bryanbendall/Brytec_SwitchPanelRev1/Board/Switch Panel Rev 1/Switch Panel Rev 1.kicad_pcb

## KiCad design Board/Switch Panel Rev 1/Switch Panel Rev 1.kicad_pcb (2023-09-28)

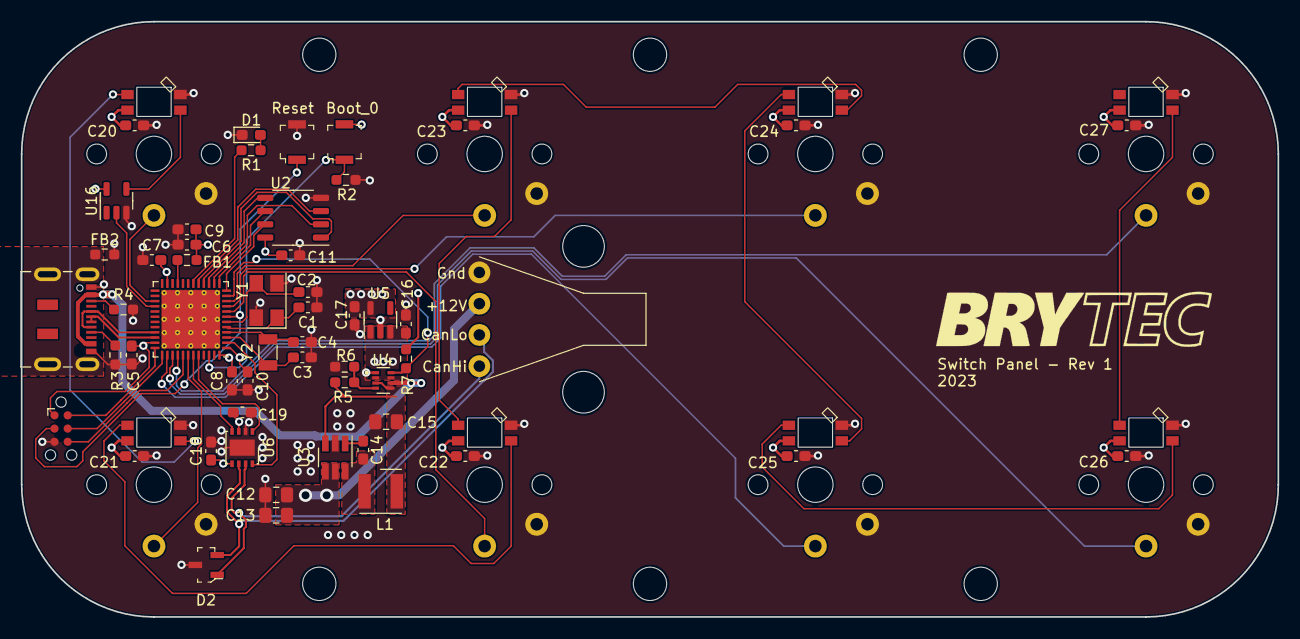
[picture p1: board Switch Panel Rev 1.kicad_pcb from above]

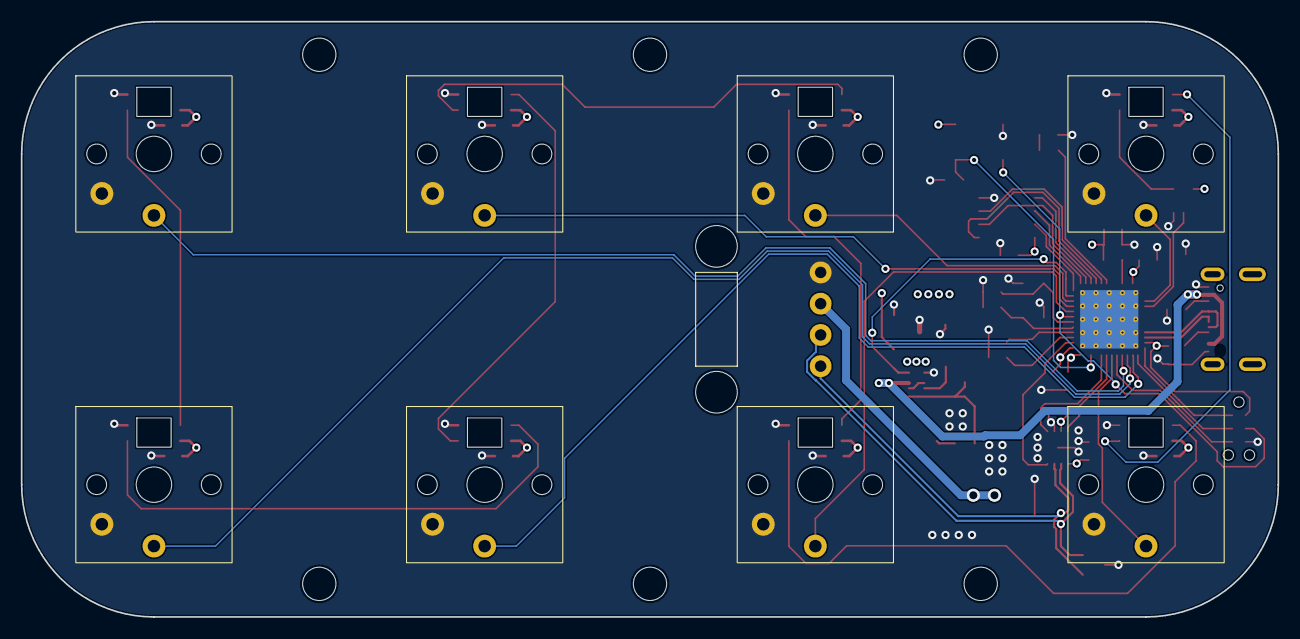
[picture p2: board Switch Panel Rev 1.kicad_pcb from below]

Board: 4 copper layers, 120.7 x 57.1 mm, 61 parts (8 on the bottom side), 55 nets.

Parts:
C1, C2, C3, C4: 10pF; C_0603_1608Metric_Pad1.08x0.95mm_HandSolder
C5, C7, C8, C10, C11, C14, C18, C19, C20, C21, C22, C23, C24, C25, C26, C27: 0.1uF; C_0603_1608Metric_Pad1.08x0.95mm_HandSolder
C6, C16, C17: 1uF; C_0603_1608Metric_Pad1.08x0.95mm_HandSolder
C9: 10nF; C_0603_1608Metric_Pad1.08x0.95mm_HandSolder
C12: 4.7uF; C_0805_2012Metric_Pad1.18x1.45mm_HandSolder
C13: 0.1uF; C_0805_2012Metric_Pad1.18x1.45mm_HandSolder
C15: 10uF; C_0805_2012Metric_Pad1.18x1.45mm_HandSolder
D1: LED_Small; LED_0603_1608Metric_Pad1.05x0.95mm_HandSolder
D2: PESD2CAN_215; SOT-23-3
FB1, FB2: FerriteBead_Small; R_0603_1608Metric_Pad0.98x0.95mm_HandSolder
J1: Conn_ARM_SWD_TagConnect_TC2030-NL; Tag-Connect_TC2030-IDC-NL_2x03_P1.27mm_Vertical
J2: USB_C_Receptacle_USB2.0; USB_C_Receptacle_JAE_DX07S016JA1R1500
J3: Conn_01x04; Tie Wrap Connector
L1: 6.8uH; L_Wurth_WE-LQSH-4020
R1: 65; R_0603_1608Metric_Pad0.98x0.95mm_HandSolder
R2, R5, R6, R7: 10K; R_0603_1608Metric_Pad0.98x0.95mm_HandSolder
R3, R4: 5.1K; R_0603_1608Metric_Pad0.98x0.95mm_HandSolder
S1, S2: B3U-1000P; Switch_Tactile_SMD_B3U-1000P
U1: STM32G491CEUx; QFN-48-1EP_7x7mm_P0.5mm_EP5.6x5.6mm_ThermalVias
U2: MB85RS64; SSOP-8_3.9x5.05mm_P1.27mm
U3: LMR50410Y5FQDBVRQ1; SOT-23-6_Handsoldering
U4: TPS2116DRLR; SOTFL50P160X60-8N
U5: AP2112K-3.3; SOT-23-5
U6: MCP2558FD-xMF; DFN-8-1EP_3x3mm_P0.65mm_EP1.55x2.4mm
U7, U8, U9, U10, U11, U12, U13, U14: SW_Kailh_Choc_RGB
U16: SN74LV1T34DBV; SOT-23-5
Y1: 8MHz; Crystal_SMD_5032-4Pin_5.0x3.2mm
Y2: 32.768kHz; Crystal_SMD_3215-2Pin_3.2x1.5mm

Connections:
+3.3V: C5.2, C6.2, C7.2, C8.2, C9.2, C10.2, C11.1, C17.1, C18.1, FB1.1, J1.1 (VCC), R7.1, S2.2, U1.1 (VBAT), U1.23 (VDD), U1.35 (VDD), U1.48 (VDD), U2.8 (VDD), U5.5 (VOUT), U6.5 (VIO)
+5V: C16.1, C19.1, C20.1, C21.1, C22.1, C23.1, C24.1, C25.1, C26.1, C27.1, U4.2 (VOUT), U4.7 (VOUT), U5.1 (VIN), U5.3 (EN), U6.3 (VDD), U7.1 (VDD), U8.1 (VDD), U9.1 (VDD), U10.1 (VDD), U11.1 (VDD), U12.1 (VDD), U13.1 (VDD), U14.1 (VDD), U16.5 (VCC)
/Mcu/BOOT_0: R2.1, S2.1, U1.46 (PB8)
/Mcu/Memory_Hold: U1.12 (PA4), U2.7 (~HOLD)
/Mcu/Memory_Wp: U1.17 (PB0), U2.3 (~WP)
/Mcu/RESET: J1.3 (~RESET), S1.1, U1.7 (PG10)
/Mcu/SPI1_SS_Memory: U1.16 (PC4), U2.1 (~CS)
/Mcu/SWCLK: J1.4 (SWCLK), U1.37 (PA14)
/Mcu/SWDIO: J1.2 (SWDIO), U1.36 (PA13)
/Mcu/SWO: J1.6 (SWO), U1.41 (PB3)
/Mcu/Usb D+: J2.A6 (D+), J2.B6 (D+), U1.34 (PA12)
/Mcu/Usb D-: J2.A7 (D-), J2.B7 (D-), U1.33 (PA11)
/Mcu/Usb_Shield: FB2.1, J2.S1 (SHIELD)
/Mcu/User_Led: R1.1, U1.18 (PB1)
Can+: D2.1 (C1), J3.1, U6.7 (CANH)
Can-: D2.2 (C2), J3.2, U6.6 (CANL)
CanRx: U1.43 (PB5), U6.4 (RXD)
CanSilent: U1.2 (PC13), U6.8 (S)
CanTx: U1.44 (PB6), U6.1 (TXD)
GND: C1.1, C2.1, C3.1, C4.1, C5.1, C6.1, C7.1, C8.1, C9.1, C10.1, C11.2, C12.2, C13.2, C15.2, C16.2, C17.2, C18.2, C19.2, C20.2, C21.2, C22.2, C23.2, C24.2, C25.2, C26.2, C27.2, D1.1 (K), D2.3 (C3), FB2.2, J1.5 (GND), J2.A1 (GND), J2.A12 (GND), J2.B1 (GND), J2.B12 (GND), J3.4, R2.2, R3.2, R4.2, R6.2, S1.2, U1.49 (VSS), U2.4 (GND), U3.2 (GND), U4.1 (GND), U5.2 (GND), U6.2 (VSS), U6.9 (VSS), U7.3 (GND), U7.6, U8.3 (GND), U8.6, U9.3 (GND), U9.6, U10.3 (GND), U10.6, U11.3 (GND), U11.6, U12.3 (GND), U12.6, U13.3 (GND), U13.6, U14.3 (GND), U14.6, U16.3 (GND), Y1.2, Y1.4
Ignition: C12.1, C13.1, J3.3, U3.4 (EN), U3.5 (VIN)
unnamed: D1.2 (A), R1.2
unnamed: J2.A5 (CC1), R4.1
unnamed: J2.B5 (CC2), R3.1
unnamed: C3.2, U1.3 (PC14), Y2.2
unnamed: C4.2, U1.4 (PC15), Y2.1
unnamed: C1.2, U1.5 (PF0), Y1.1
unnamed: C2.2, U1.6 (PF1), Y1.3
unnamed: FB1.2, U1.21 (VDDA)
unnamed: C14.2, U3.1 (CB)
unnamed: C14.1, L1.1, U3.6 (SW)
unnamed: R5.2, R6.1, U4.4 (PR1)
unnamed: U7.2 (DO), U9.4 (DI)
unnamed: U8.2 (DO), U10.4 (DI)
unnamed: U10.2 (DO), U12.4 (DI)
unnamed: U9.2 (DO), U11.4 (DI)
unnamed: U11.2 (DO), U13.4 (DI)
unnamed: U12.2 (DO), U14.4 (DI)
unnamed: U8.4 (DI), U13.2 (DO)
unnamed: U7.4 (DI), U16.4 (Y)
PowerSwitchStatus: R7.2, U1.11 (PA3), U4.8 (ST)
RGB_DI: U1.28 (PB15), U16.2 (A)
Regulated 5V: C15.1, L1.2, R5.1, U3.3 (FB), U4.3 (VIN1), U4.5 (MODE)
SPI1_Miso: U1.14 (PA6), U2.2 (SO)
SPI1_Mosi: U1.15 (PA7), U2.5 (SI)
SPI1_Sclk: U1.13 (PA5), U2.6 (SCK)
Sw1: U1.27 (PB14), U7.5
Sw2: U1.42 (PB4), U9.5
Sw3: U1.8 (PA0), U11.5
Sw4: U1.10 (PA2), U13.5
Sw5: U1.9 (PA1), U8.5
Sw6: U1.38 (PA15), U10.5
Sw7: U1.39 (PC10), U12.5
Sw8: U1.40 (PC11), U14.5
Usb 5V: J2.A4 (VBUS), J2.A9 (VBUS), J2.B4 (VBUS), J2.B9 (VBUS), U4.6 (VIN2)
