bryanbendall/Brytec_SwitchPanelRev1/Firmware/SwitchPanelRev1.ioc

Mcu.UserName=STM32G491CEUx
PA0.GPIO_Label=Sw3
PA0.Signal=GPIO_Input
PA1.GPIO_Label=Sw5
PA1.Signal=GPIO_Input
PA11.Signal=USB_DM
PA12.Signal=USB_DP
PA13.Signal=SYS_JTMS-SWDIO
PA14.Signal=SYS_JTCK-SWCLK
PA15.GPIO_Label=Sw6
PA15.Signal=GPIO_Input
PA2.GPIO_Label=Sw4
PA2.Signal=GPIO_Input
PA3.GPIO_Label=PowerSwitchStatus
PA3.Signal=GPIO_Input
PA4.GPIO_Label=Memory_Hold
PA4.Signal=GPIO_Output
PA5.Signal=SPI1_SCK
PA6.Signal=SPI1_MISO
PA7.Signal=SPI1_MOSI
PB0.GPIO_Label=Memory_Wp
PB0.Signal=GPIO_Output
PB1.GPIO_Label=User_Led
PB1.Signal=GPIO_Output
PB14.GPIO_Label=Sw1
PB14.Signal=GPIO_Input
PB15.Signal=TIM1_CH3N
PB4.GPIO_Label=Sw2
PB4.Signal=GPIO_Input
PB5.Signal=FDCAN2_RX
PB6.Signal=FDCAN2_TX
PC10.GPIO_Label=Sw7
PC10.Signal=GPIO_Input
PC11.GPIO_Label=Sw8
PC11.Signal=GPIO_Input
PC13.GPIO_Label=CanSilent
PC13.Signal=GPIO_Output
PC14-OSC32_IN.Signal=RCC_OSC32_IN
PC15-OSC32_OUT.Signal=RCC_OSC32_OUT
PC4.GPIO_Label=Memory_SS
PC4.Signal=GPIO_Output
PF0-OSC_IN.Signal=RCC_OSC_IN
PF1-OSC_OUT.Signal=RCC_OSC_OUT
