bryanbendall/Brytec_SwitchPanelRev1/Firmware/Core/Inc/main.h

#define CanSilent_Pin GPIO_PIN_13
#define CanSilent_GPIO_Port GPIOC
#define Sw3_Pin GPIO_PIN_0
#define Sw3_GPIO_Port GPIOA
#define Sw5_Pin GPIO_PIN_1
#define Sw5_GPIO_Port GPIOA
#define Sw4_Pin GPIO_PIN_2
#define Sw4_GPIO_Port GPIOA
#define PowerSwitchStatus_Pin GPIO_PIN_3
#define PowerSwitchStatus_GPIO_Port GPIOA
#define Memory_Hold_Pin GPIO_PIN_4
#define Memory_Hold_GPIO_Port GPIOA
#define Memory_SS_Pin GPIO_PIN_4
#define Memory_SS_GPIO_Port GPIOC
#define Memory_Wp_Pin GPIO_PIN_0
#define Memory_Wp_GPIO_Port GPIOB
#define User_Led_Pin GPIO_PIN_1
#define User_Led_GPIO_Port GPIOB
#define Sw1_Pin GPIO_PIN_14
#define Sw1_GPIO_Port GPIOB
#define Sw6_Pin GPIO_PIN_15
#define Sw6_GPIO_Port GPIOA
#define Sw7_Pin GPIO_PIN_10
#define Sw7_GPIO_Port GPIOC
#define Sw8_Pin GPIO_PIN_11
#define Sw8_GPIO_Port GPIOC
#define Sw2_Pin GPIO_PIN_4
#define Sw2_GPIO_Port GPIOB
