bryanbendall/Brytec_SwitchPanelRev1/Firmware/App/SwitchPanelRev1Defs.h

#pragma once

#include <stdint.h>

// Pin Defines
#define BT_PIN_Button_1 0
#define BT_PIN_Button_2 1
#define BT_PIN_Button_3 2
#define BT_PIN_Button_4 3
#define BT_PIN_Button_5 4
#define BT_PIN_Button_6 5
#define BT_PIN_Button_7 6
#define BT_PIN_Button_8 7
#define BT_PIN_Light_1 8
#define BT_PIN_Light_2 9
#define BT_PIN_Light_3 10
#define BT_PIN_Light_4 11
#define BT_PIN_Light_5 12
#define BT_PIN_Light_6 13
#define BT_PIN_Light_7 14
#define BT_PIN_Light_8 15

// Can Bus Defines
#define BT_CAN_Yellow_Green 0

// Module Template
constexpr uint8_t moduleTemplate[] = {
0x54,0x4d,0,0x1,0x12,0,0,0,0x53,0x77,0x69,0x74,0x63,0x68,0x20,0x50,0x61,0x6e,0x65,0x6c,0x20,0x52,0x65,0x76,0x20,0x31,0x6,0,0,0,0x42,0x72,0x79,0x74,0x65,0x63,0x12,0,0,0,0x53,0x77,0x69,0x74,0x63,0x68,0x20,0x50,0x61,0x6e,0x65,0x6c,0x20,0x52,0x65,0x76,0x20,0x31,0x28,0x1,0x6,0,0,0,0x59,0x65,0x6c,0x6c,0x6f,0x77,0x5,0,0,0,0x47,0x72,0x65,0x65,0x6e,0x10,0,0x8,0,0,0,0x42,0x75,0x74,0x74,0x6f,0x6e,0x20,0x31,0x1,0x5,0,0,0x8,0,0,0,0x42,0x75,0x74,0x74,0x6f,0x6e,0x20,0x32,0x1,0x5,0,0,0x8,0,0,0,0x42,0x75,0x74,0x74,0x6f,0x6e,0x20,0x33,0x1,0x5,0,0,0x8,0,0,0,0x42,0x75,0x74,0x74,0x6f,0x6e,0x20,0x34,0x1,0x5,0,0,0x8,0,0,0,0x42,0x75,0x74,0x74,0x6f,0x6e,0x20,0x35,0x1,0x5,0,0,0x8,0,0,0,0x42,0x75,0x74,0x74,0x6f,0x6e,0x20,0x36,0x1,0x5,0,0,0x8,0,0,0,0x42,0x75,0x74,0x74,0x6f,0x6e,0x20,0x37,0x1,0x5,0,0,0x8,0,0,0,0x42,0x75,0x74,0x74,0x6f,0x6e,0x20,0x38,0x1,0x5,0,0,0x7,0,0,0,0x4c,0x69,0x67,0x68,0x74,0x20,0x31,0x1,0xa,0,0,0x7,0,0,0,0x4c,0x69,0x67,0x68,0x74,0x20,0x32,0x1,0xa,0,0,0x7,0,0,0,0x4c,0x69,0x67,0x68,0x74,0x20,0x33,0x1,0xa,0,0,0x7,0,0,0,0x4c,0x69,0x67,0x68,0x74,0x20,0x34,0x1,0xa,0,0,0x7,0,0,0,0x4c,0x69,0x67,0x68,0x74,0x20,0x35,0x1,0xa,0,0,0x7,0,0,0,0x4c,0x69,0x67,0x68,0x74,0x20,0x36,0x1,0xa,0,0,0x7,0,0,0,0x4c,0x69,0x67,0x68,0x74,0x20,0x37,0x1,0xa,0,0,0x7,0,0,0,0x4c,0x69,0x67,0x68,0x74,0x20,0x38,0x1,0xa,0,0,
};
