bryanbendall/Brytec_SwitchPanelRev1/Firmware/App/CanBusDefs.cpp

#include "CanBusDefs.h"

#include "SwitchPanelRev1Defs.h"

namespace CanBusDefs {

FDCAN_HandleTypeDef* getCanBus(uint8_t index)
{
    switch (index) {
    case BT_CAN_Yellow_Green:
        return &hfdcan2;
    }

    return nullptr;
}

uint8_t getCanBusIndex(FDCAN_HandleTypeDef* bus)
{
    if (bus == &hfdcan2)
        return BT_CAN_Yellow_Green;

    return UINT8_MAX;
}

}
