bryanbendall/Brytec_SwitchPanelRev1/(commit log)

2023-09-06 Board Work
    [CanBus.kicad_sch, Mcu.kicad_sch, PowerRegulation.kicad_sch, Switch Panel Rev 1.kicad_pcb, Switch Panel Rev 1.kicad_sch, Switches.kicad_sch]
2023-09-11 Board Updates
    [Connector.kicad_sch, Mcu.kicad_sch, Switch Panel Rev 1.kicad_pcb, Switch Panel Rev 1.kicad_sch]
2023-09-28 Added output files and bom file
    [Switch Panel Rev 1-B_Cu.gbl, Switch Panel Rev 1-B_Mask.gbs, Switch Panel Rev 1-B_Paste.gbp, Switch Panel Rev 1-B_Silkscreen.gbo, Switch Panel Rev 1-Edge_Cuts.gm1, Switch Panel Rev 1-F_Cu.gtl, Switch Panel Rev 1-F_Mask.gts, Switch Panel Rev 1-F_Paste.gtp]
2023-10-26 Added rgb led files and test
2023-11-10 Working leds and buttons
2023-11-10 Buttons and leds in correct order
    [SwitchPanelRev1Board.cpp, cppMain.cpp]
2023-11-11 Working canbus
2023-11-17 Turn on can interrupt
2023-11-20 Updates for canbus from submodule
2024-01-09 Added can bus defs file Updated submodules Can working better with multiple channels Starting can with speed specified
